sjoppich/ELEC5552-Team-14/Code/Arduino Mega Pinouts.pdf

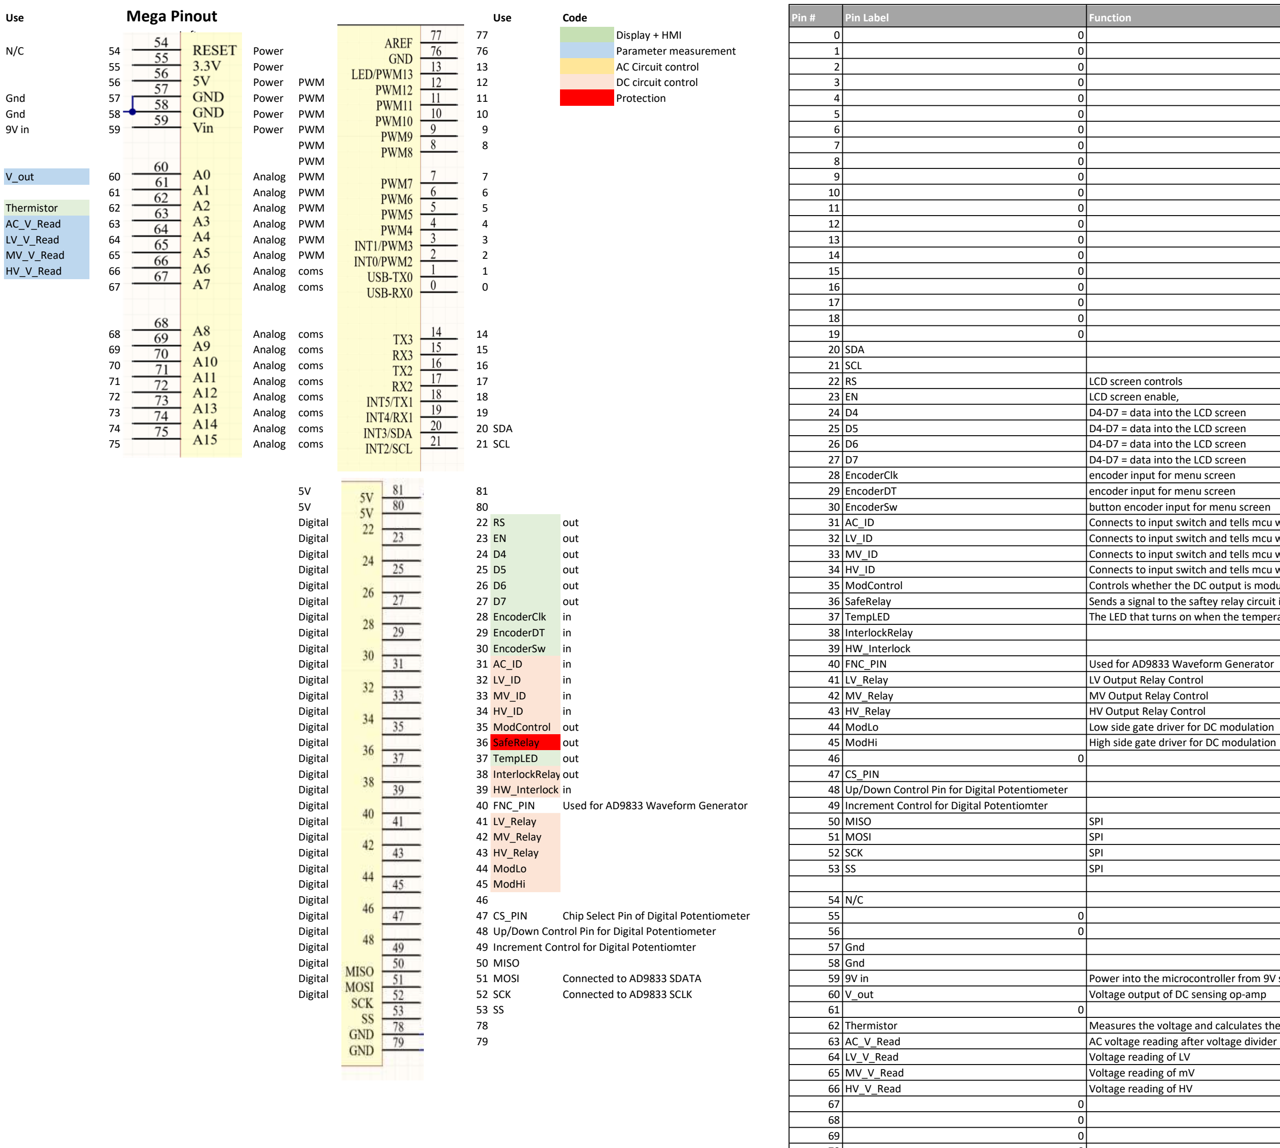
[picture p1: figure]
Use; Mega Pinout; Code; Pin #; Pin Label; Function; Left; Display + HMI; Power; Parameter measurement; AC Circuit control; Power PWM; DC circuit control; Gnd; Protection; PWM; V_out; Analog PWM; Thermistor; AC_V_Read; LV_V_Read; MV_V_Read; HV_V_Read; Analog coms; SDA; SCL; LCD screen controls; LCD screen enable,; D4-D7 = data into the LCD screen; EncoderClk; encoder input for menu screen; EncoderDT; Digital; 29 EncoderDT; InterlockRelay; 30 EncoderSw in; HW_Interlock; FNC_PIN; Used for AD9833 Waveform Generator; LV_Relay; LV Output Relay Control; MV_Relay; MV Output Relay Control; HV_Relay; HV Output Relay Control; 37 TempLED; out; InterlockRelay out; CS_PIN; 40 FNC_PIN; Increment Control for Digital Potentiomter; MISO; SPI; MOSI; SCK; ModLo; 45 ModHi; 50 MISO; Voltage reading of LV; Voltage reading of mV; Voltage reading of HV
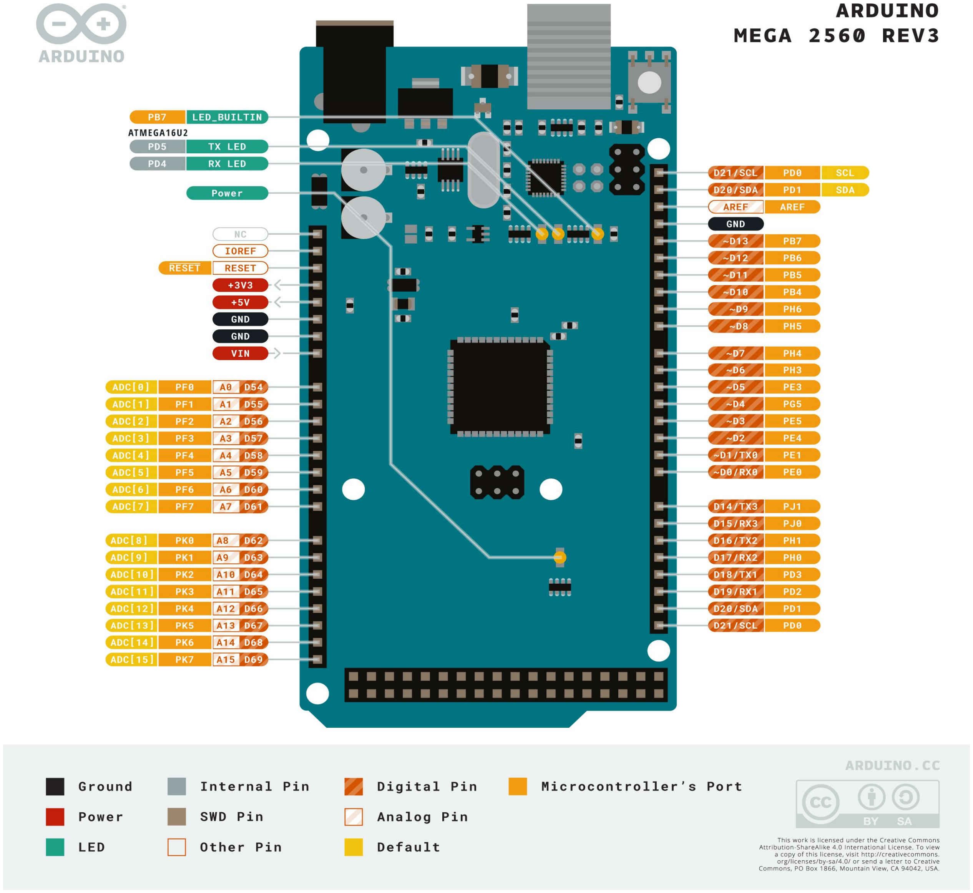
[picture p2: figure]

73 | Analog coms | 19 | 24 | D4 | D4-D7 = data into the LCD screen
74 | Analog coms | 20 SDA | 25 | D5 | D4-D7 = data into the LCD screen
75 | Analog coms | 21 SCL | 26 | D6 | D4-D7 = data into the LCD screen
5V | 80 | | 30 | EncoderSw | button encoder input for menu screen
Digital | 22 RS | out | 31 | AC_ID | Connects to input switch and tells mcu whether its switched to HV,MV,LV or AC
Digital | 23 EN | out | 32 | LV_ID | Connects to input switch and tells mcu whether its switched to HV,MV,LV or AC
Digital | 24 D4 | out | 33 | MV_ID | Connects to input switch and tells mcu whether its switched to HV,MV,LV or AC
Digital | 25 D5 | out | 34 | HV_ID | Connects to input switch and tells mcu whether its switched to HV,MV,LV or AC
Digital | 26 D6 | out | 35 | ModControl | Controls whether the DC output is modulated or not
Digital | 27 D7 | out | 36 | SafeRelay | Sends a signal to the saftey relay circuit in case of overcurrent, thermal overheat or other failure
Digital | 28 EncoderClk in | 37 | TempLED | The LED that turns on when the temperature warning is exceeded
Digital | 35 ModControl out | 44 | ModLo | Low side gate driver for DC modulation
Digital | 36 SafeRelay | out | 45 | ModHi | High side gate driver for DC modulation
Digital | 39 | HW_Interlock in | 48 | Up/Down Control Pin for Digital Potentiometer
Digital | 47 CS_PIN | Chip Select Pin of Digital Potentiometer | 55 | 0
Digital | 48 Up/Down Control Pin for Digital Potentiometer | 56 | 0
Digital | 49 Increment Control for Digital Potentiomter | 57 | Gnd
Digital | 51 MOSI | Connected to AD9833 SDATA | 59 | 9V in | Power into the microcontroller from 9V supply
Digital | 52 SCK | Connected to AD9833 SCLK | 60 | V_out | Voltage output of DC sensing op-amp
| 78 | | 62 | Thermistor | Measures the voltage and calculates the resulting temperature
| 79 | | 63 | AC_V_Read | AC voltage reading after voltage divider

70 0
71 0
72 0
73 0
74 0
75 0
76 0
77 0
78 0
79 0
80 0
81 0
