sjoppich/ELEC5552-Team-14/Altium Schematics+PCB/ELEC5552_Team_14_Schematic.pdf

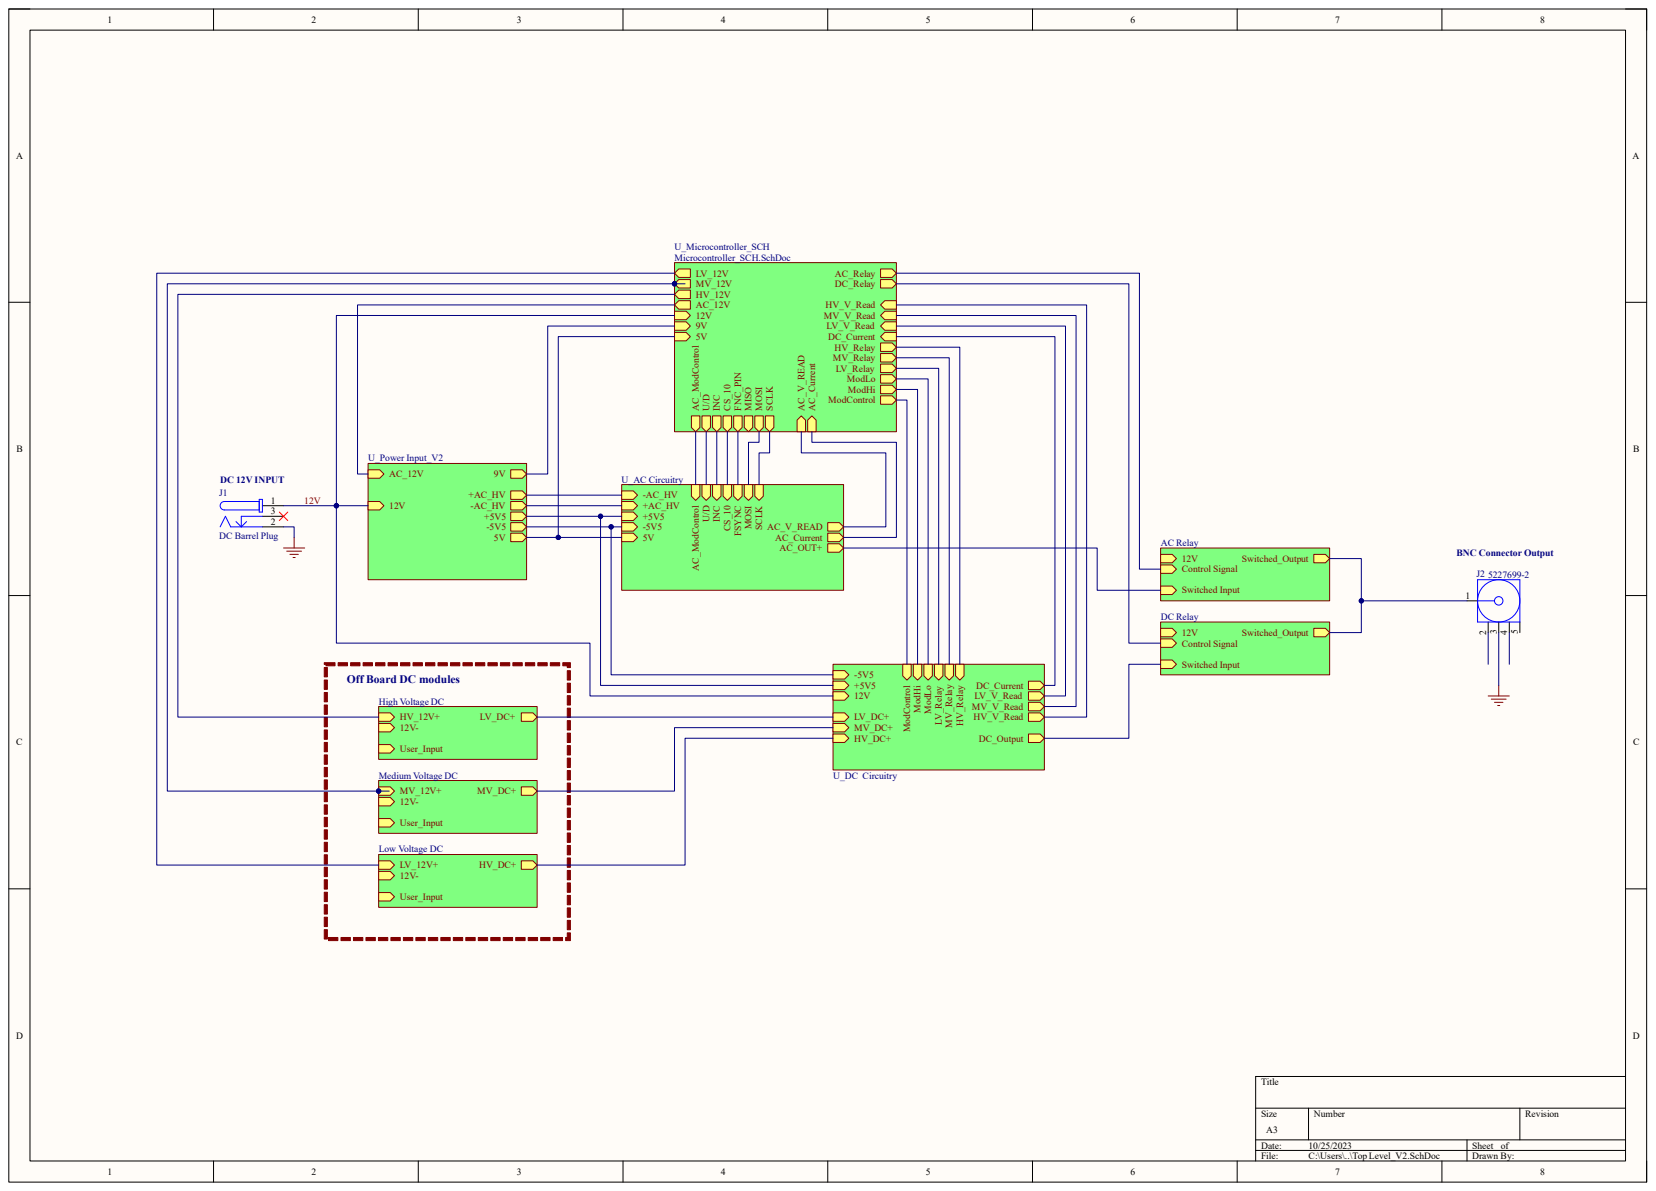
[picture p19: page 1]
Title; Size; Number; Revision; Date:; Sheet of; File:; C:\Users\..\Top Level_V2.SchDoc; Drawn By:; AC_V_READ; LV_V_Read; MV_V_Read; HV_V_Read; ModControl; AC_Relay; DC_Current AC_Current; DC_Relay FNC_PIN; LV_Relay; MV_Relay; HV_Relay; ModLo; ModHi AC_ModControl U/D INC CS_10; MISO MOSI SCLK; U_Microcontroller_SCH Microcontroller_SCH.SchDoc; User_Input; Low Voltage DC; High Voltage DC; Medium Voltage DC; DC 12V INPUT; U_Power Input_V2; DC_Current; DC_Output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

DC Barrel Plug

BNC Connector Output

Off Board DC modules

# ELV Supply Voltages

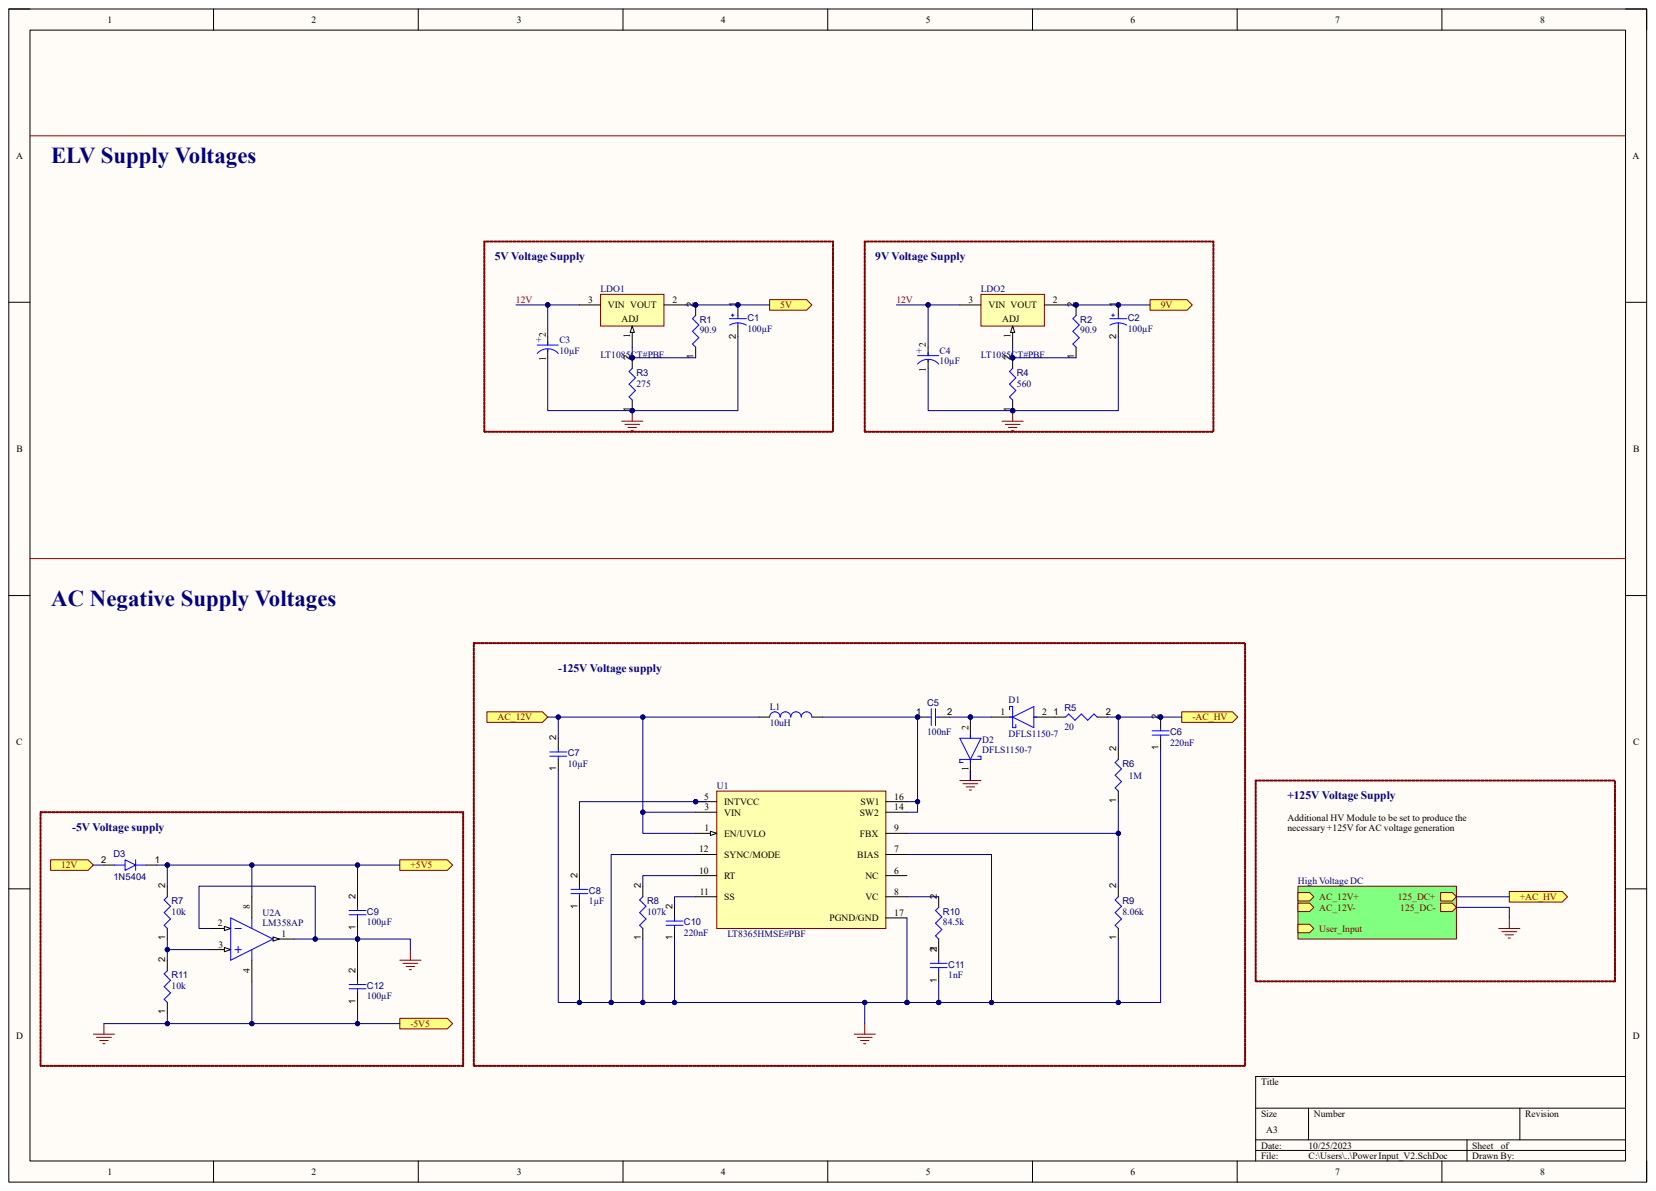
[picture p20: page 2]

AC Negative Supply Voltages

Additional HV Module to be set to produce the
necessary +125V for AC voltage generation

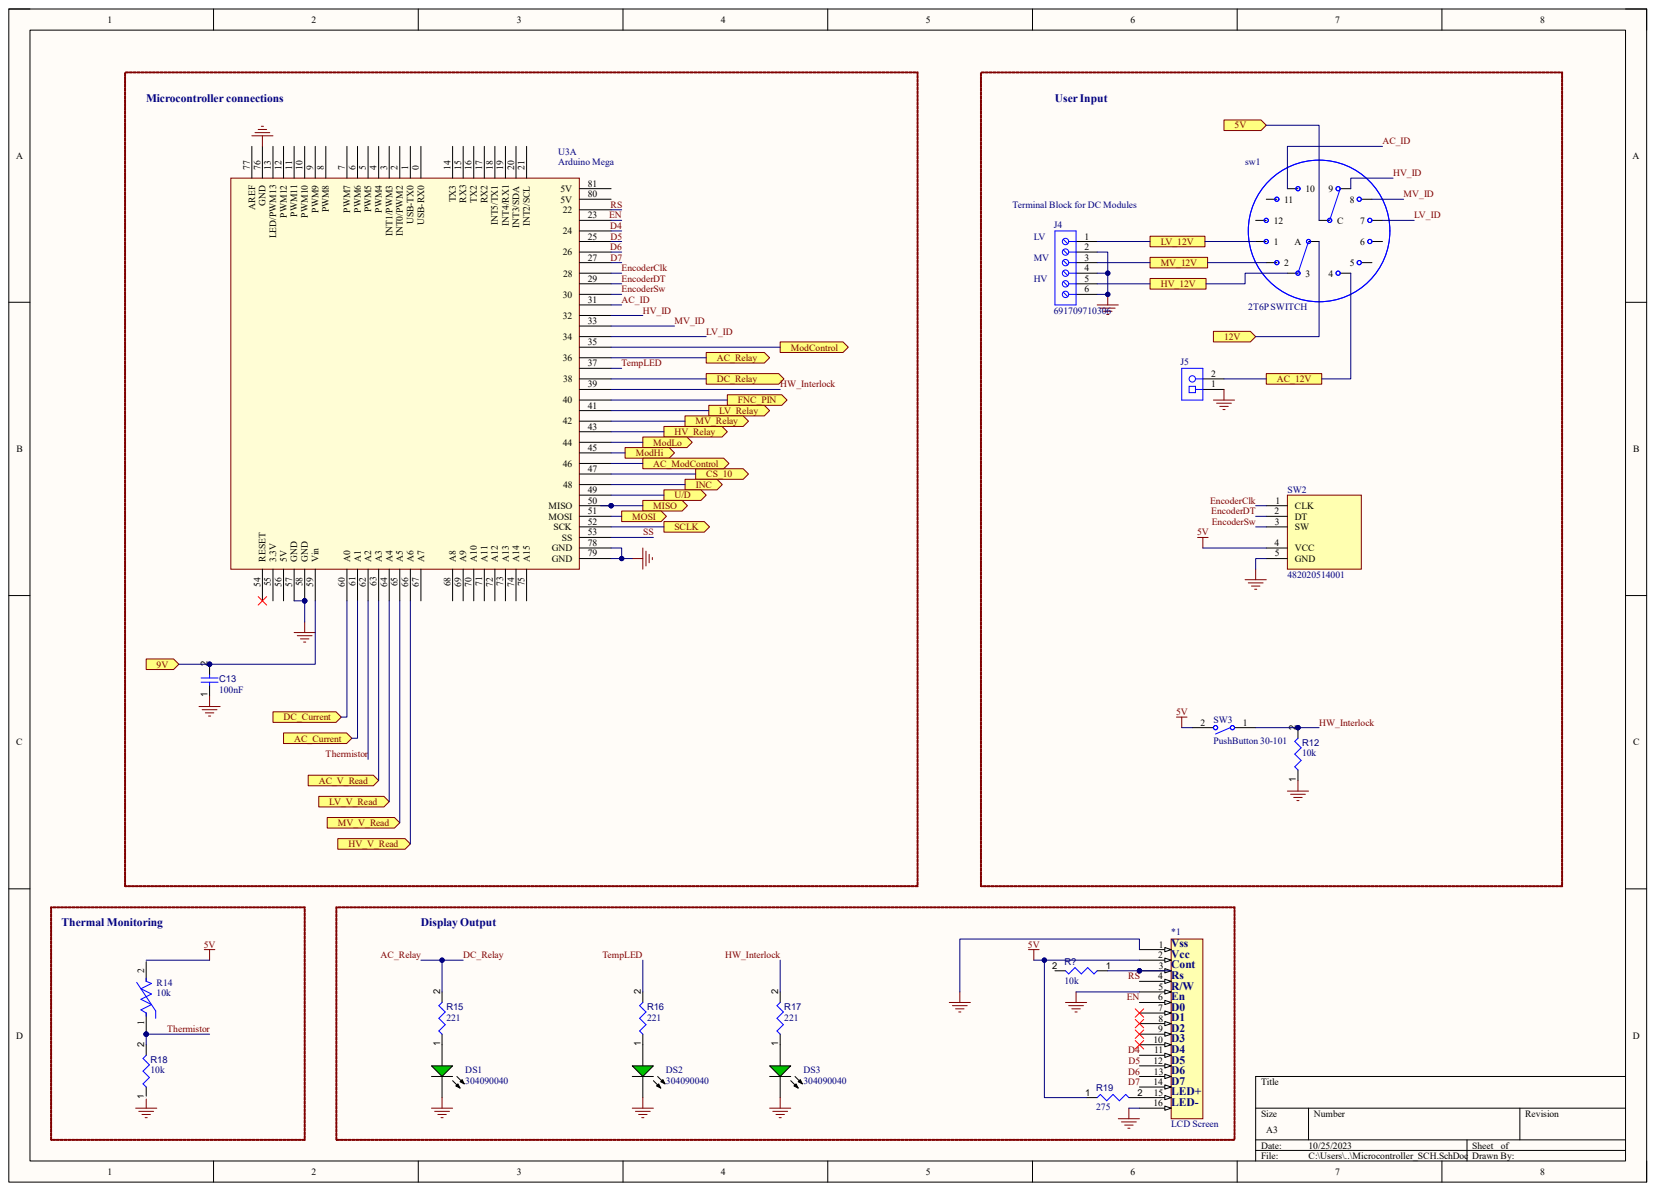
[picture p21: page 3]

Terminal Block for DC Modules

# TL071CP ⁺⁵V⁵ -5V⁵

C17 1 2

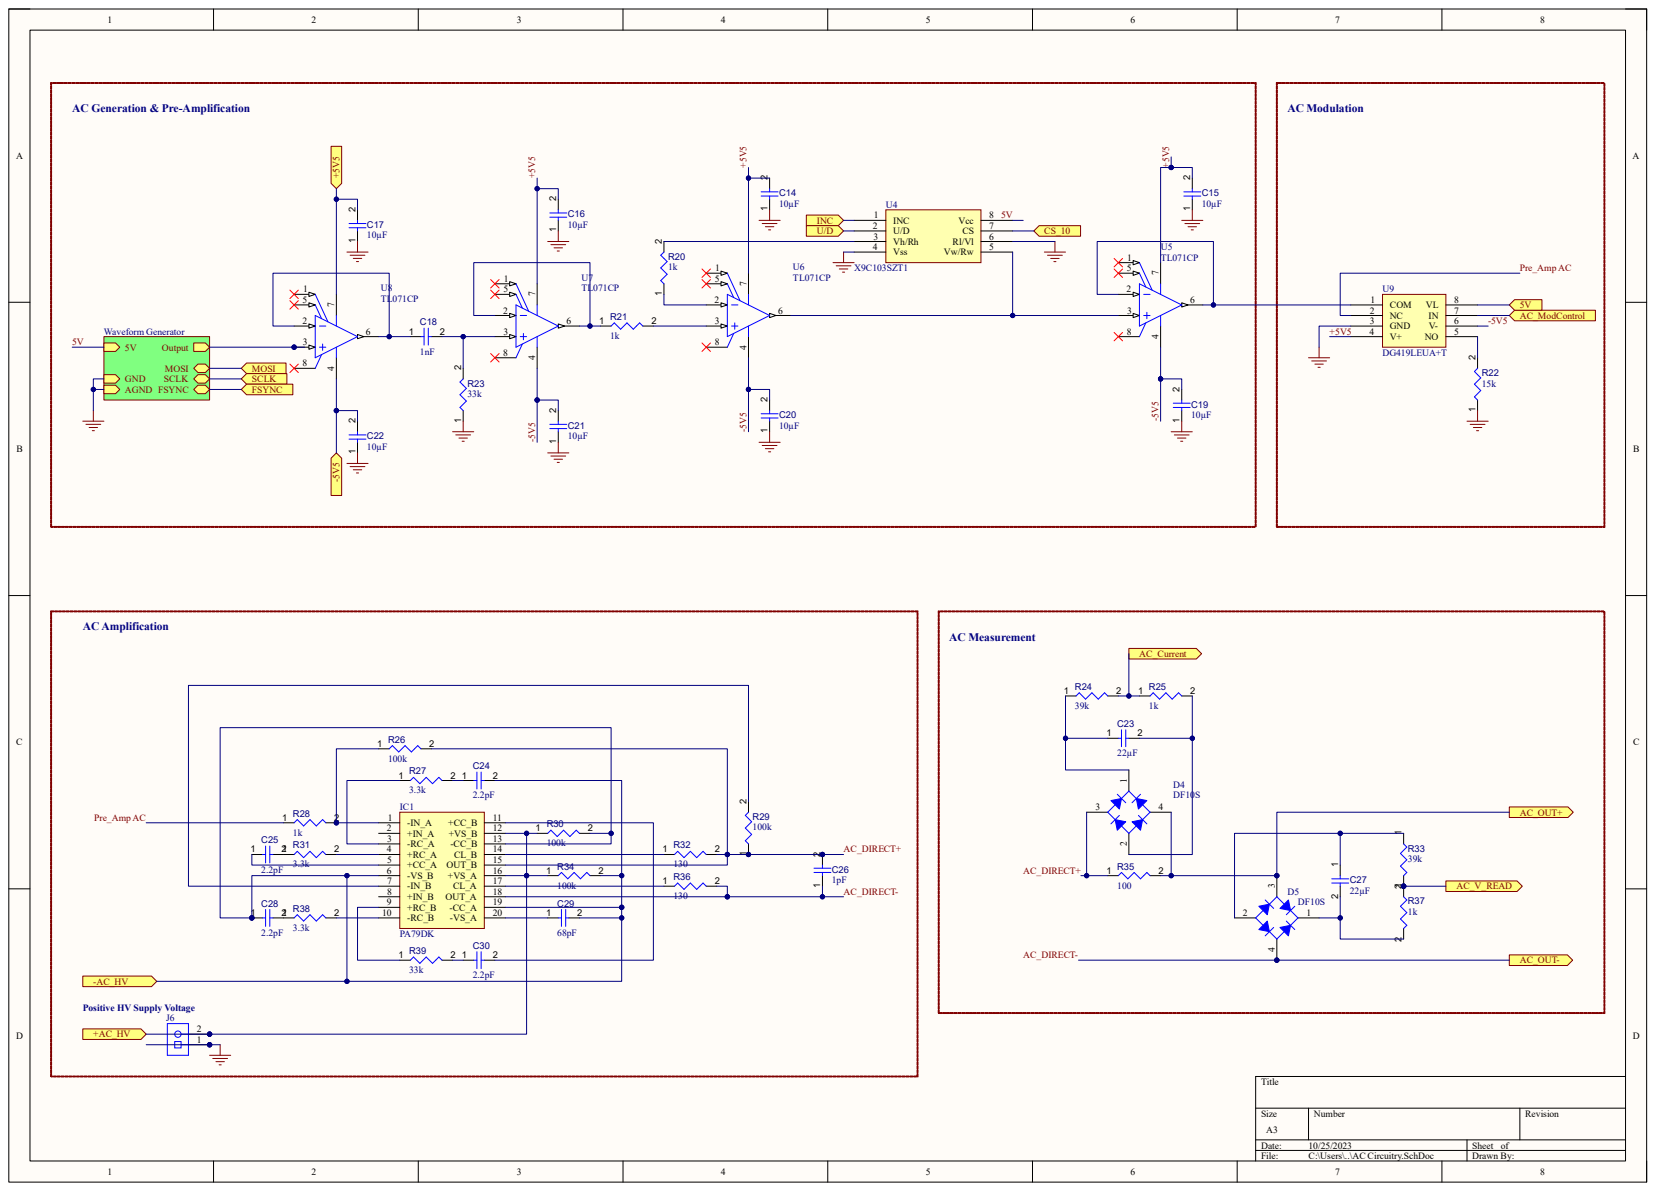
[picture p22: page 4]

AC Generation & Pre-Amplification

Positive HV Supply Voltage

A A

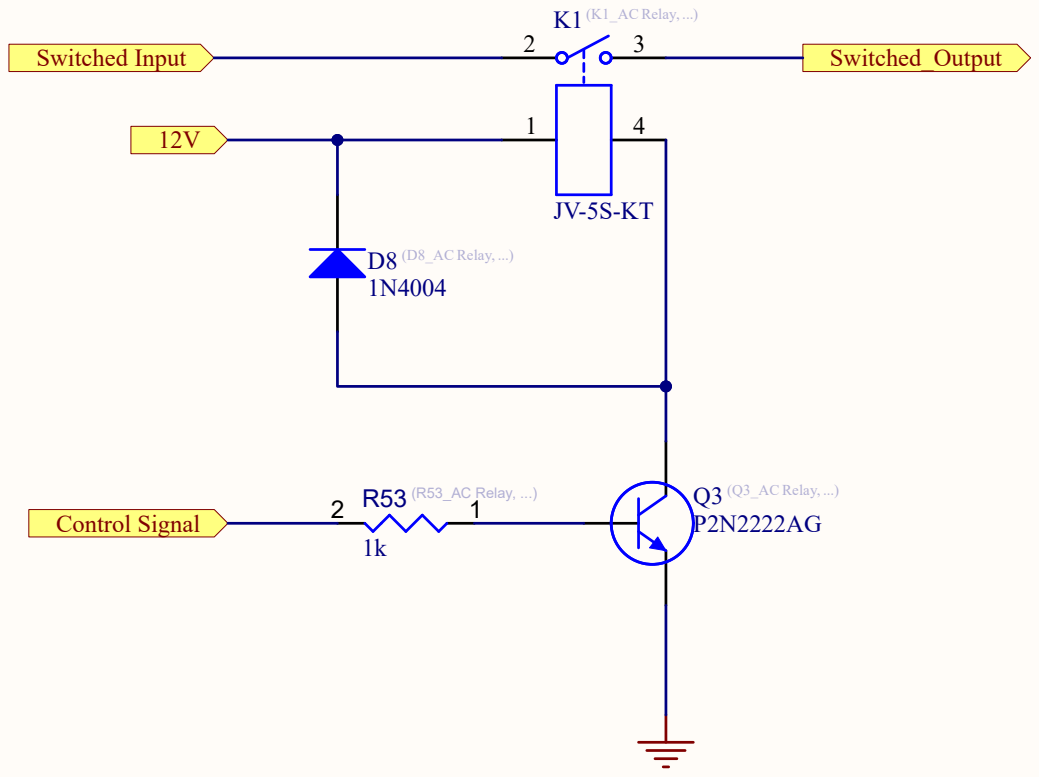
[picture p23: page 5]
Title; Size; Number; Revision; File:; C:\Users\..\Relay Control.SchDoc; Drawn By:; Q3 ⁽Q3_AC Relay, ...) P2N2222AG; D8 ⁽D8_AC Relay, ...) 1N4004; K1⁽K1_AC Relay, ...); R53 ⁽R53_AC Relay, ...); Switched Input; Switched_Output; Control Signal

R41 2 1

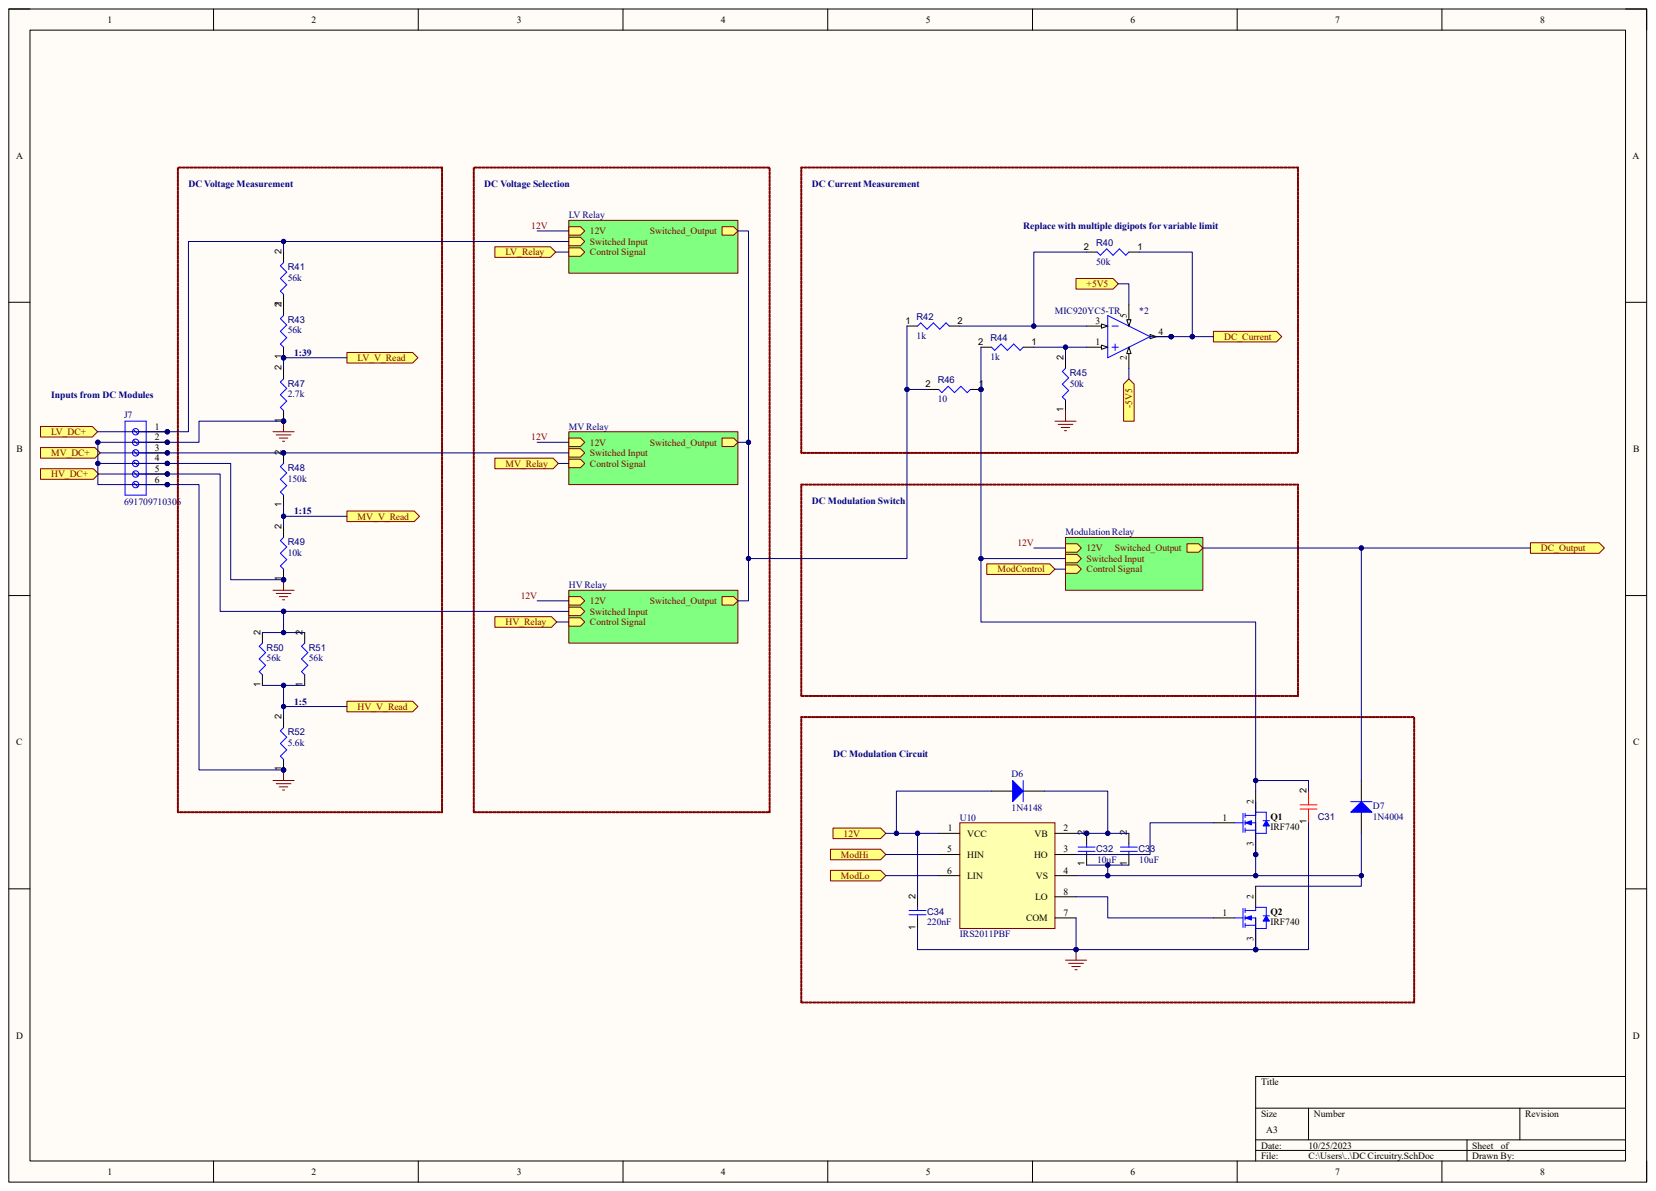
[picture p24: page 6]

Replace with multiple digipots for variable limit
