sjoppich/ELEC5552-Team-14/Block Diagram/ELEC5552 System block Diagram_V2.pdf

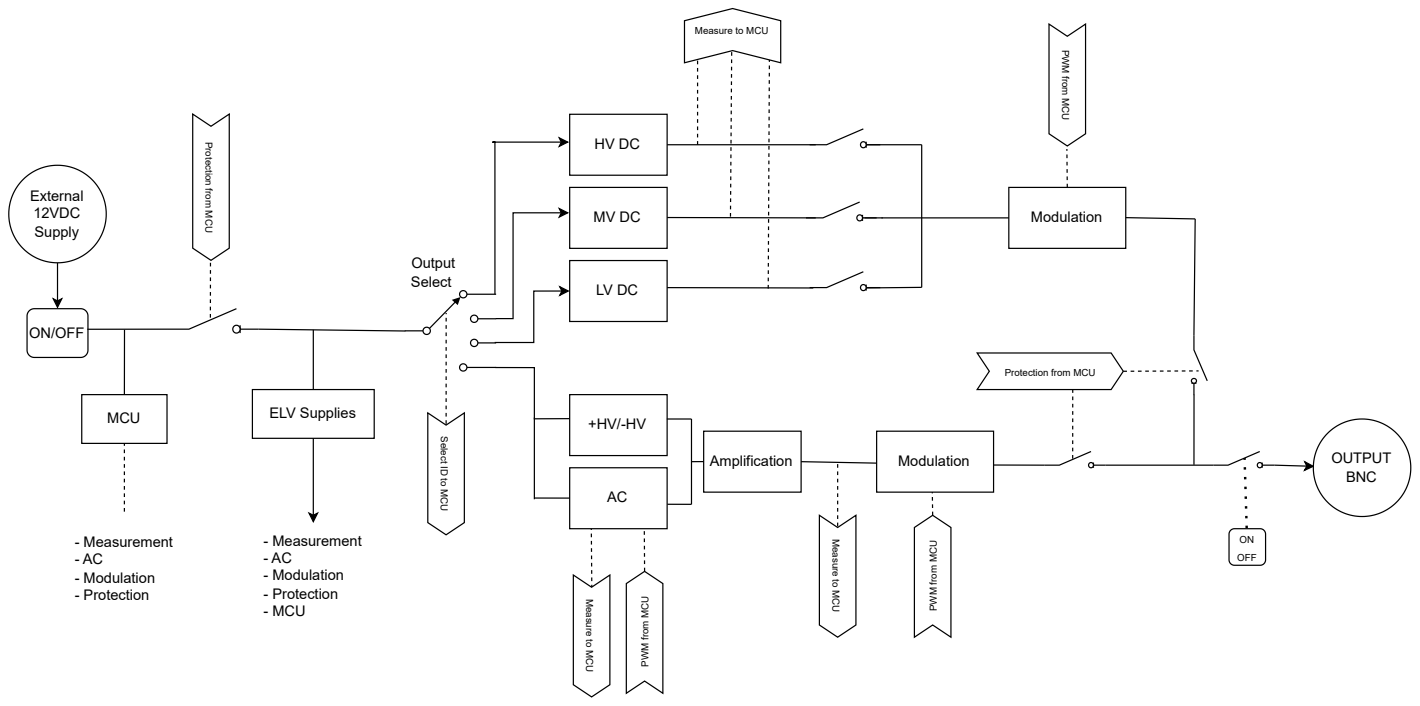
[picture p25: page 1]
Modulation; Amplification; ON/OFF; MCU; ELV Supplies; External 12VDC Supply; OUTPUT BNC; - Measurement - AC - Modulation - Protection - MCU; - Measurement - AC - Modulation - Protection; OFF

Measure to MCU

PWM from MCU

Protection from MCU

Output
Select Select ID to MCU
