sjoppich/ELEC5552-Team-14/Simulation Files/05. DC measurement + protection/DC current measurement + protection_simplified.asc

C1: cap; 100p
R1: res; 47k
R2: res; 1k
R3: res; 47k
R4: res; 1k
Rs: res; 10
V1: voltage; 200
Named nets: 0, V1, V2, V2_scaled, V1_scaled
.tran 10
To microcontroller
Current-sensing resistor
MEMS load
To microcontroller
