sjoppich/ELEC5552-Team-14/Simulation Files/01. Component Low Voltage Generation/LT1085_3_3_V_Power_Supply_Schematic.asc

C1: cap; 100µ
C2: cap; 10µ
R1: res; 275
R2: res; 90.9
U1: LT1085
V1: voltage; PULSE(0 12 500n 0 0 20m 20m)
Named nets: 0, V_OUT
.tran 0 1 0 1m
