sjoppich/ELEC5552-Team-14/Simulation Files/02. Waveform Generation/Practical_Single_Stage_Inverting_Amplifier_Schematic_with_Buffer_With_Actual_Parts.asc

R1: res; 10k
R2: res; 28.2
U1: LT1818
U2: LT1818
V1: signal; SINE(0 0.65 50K)
V2: voltage; -10
V3: voltage; 30
V6: voltage; -10
V7: voltage; 10
Named nets: 0, V_Out
.tran 0 50u 0 1u
