sjoppich/ELEC5552-Team-14/Simulation Files/03. AC measurement/Full bridge rectifier.asc

C5: cap; 10n; V=4 Irms=2.7 Rser=0.035 Lser=0
C6: cap; 0.47n
C7: cap; 220µ; V=4 Irms=2.7 Rser=0.035 Lser=0
C8: cap; 0.47n
C9: cap; 10p
C10: cap; 10n; V=4 Irms=2.7 Rser=0.035 Lser=0
D9: schottky; 1N5819
D10: schottky; 1N5819
D11: schottky; 1N5819
D12: schottky; 1N5819
D13: schottky; 1N5819
D14: schottky; 1N5819
D15: schottky; 1N5819
D16: schottky; 1N5819
D17: schottky; 1N5819
D18: schottky; 1N5819
D19: schottky; 1N5819
D20: schottky; 1N5819
R1: res; 0
R2: res; 0
R8: res; 30k
R9: res; 500
R10: res; 10k
R11: res; 1m
R12: res; 60k
R13: res; 1k
R14: res; 10k
R15: res; 30k
R16: res; 400
V2: voltage; SINE(-0.1 70 300k)
V3: voltage; SINE(-0.1 288 10k)
Named nets: 0
;dc AC 20 5s 0 0.2
;dc AC 20 5s 0 0.2
Load
Scaled Voltage
.tran 0 50us 0
Leftovers- ignore
Will need to check power ability of the resistors- cant handle high voltage
