sjoppich/ELEC5552-Team-14/Simulation Files/04. DC to AC Full Stage/Practical_Single_Stage_Inverting_Amplifier_Schematic_with_Buffer_With_Actual_Parts.asc

L1: ind
R1: res; 10k
R2: res; 50k
R3: res; 1k
R4: res; 10k
U1: LT1818
U2: LT1818
U3: LT1818
U4: ADHV4702-1
V1: voltage; 110
V2: voltage; -5
V3: signal; SINE(0 0.65 300K)
V4: voltage; -110
V5: signal; SINE(0 35 50K)
V10: voltage; 5
Named nets: 0, V+5, V-5, V_Wave, V+High, V-Low, V_Out, V_Pre, V_Wave_Comparsion
.tran 0 50u 0 1u
