sjoppich/ELEC5552-Team-14/Simulation Files/05. DC measurement + protection/DC current measurement + protection.asc

I1: current; 10m
R1: res; 1k
R2: res; 50k
R3: res; 1k
R4: res; 50k
R5: res; 100
R6: res; 100
R7: res; 100k
Rs: res; 10
U1: OP27
V1: voltage; 9
V2: voltage; -9V
Named nets: 0, V1, V2, V_out, V+, V-
.tran 10
Current-sensing resistor
To microcontroller
To load
