sjoppich/ELEC5552-Team-14/Simulation Files/01. Component Low Voltage Generation/Component Voltage Generation/Component_Voltage_Generation_LT_Spice_Schematic.asc

C1: cap; 100µ
C2: cap; 10µ
C3: cap; 100µ
C4: cap; 10µ
C5: cap; 100µ
C6: cap; 10µ
R1: res; 560
R2: res; 90.9
R3: res; 150
R4: res; 90.9
R5: res; 277
R6: res; 90.9
U1: LT1085
U2: LT1085
U3: LT1085
V1: voltage; PULSE(0 12 500n 0 0 20m 20m)
V2: voltage; PULSE(0 12 500n 0 0 20m 20m)
V3: voltage; PULSE(0 12 500n 0 0 20m 20m)
Named nets: 0, V_OUT3, V_OUT, V_OUT2
.tran 1
