sjoppich/ELEC5552-Team-14/Simulation Files/06. Dual Supply/5V.asc

C1: cap; 100µ
C2: cap; 100µ
D1: diode
R1: res; 10k
R2: res; 10k
U1: AD711
V1: voltage; 12
Named nets: 0
.tran 30
