sjoppich/ELEC5552-Team-14/Simulation Files/06. Dual Supply/lt8365_boost.asc

C1: cap; 0.22µ
C2: cap; 1µ
C3: cap; 1000p
C4: cap; .22µ; Rser=9m
C5: cap; 10µ
C6: cap; 0.1µ
D1: schottky; RB068L150
D2: schottky; RB068L150
L1: ind; 10µ; Rser=6m
R1: res; 107K
R2: res; 1Meg
R3: res; 5.5k
R4: res; 84.5K
R5: res; 20
U1: LT8365
V1: VOLTAGE; 12
Named nets: 0, IN, OUT
.tran 10 steady
Note:
  A smaller SS capacitor is being used to reduce simulation time. See datasheet for typical values.
  If the simulation model is not found please update with the "Sync Release" command from the "Tools" menu.
  It remains the customer's responsibility to verify proper and reliable operation in the actual application.
  Component substitution and printed circuit board layout may significantly affect circuit performance or reliability.
  Contact your local sales representative for assistance. This circuit is distributed to customers only for use with LTC parts.
  Copyright © 2020 Analog Devices Inc. All rights reserved.
LT8365 - Low Iq Boost/SEPIC/Inverting DC/DC Converter with 1.5A, 150V Switch
125V Boost Converter
Input: 9V to 30V     Output: 125V @ 20mA, Fsw = 400KHz
