sjoppich/ELEC5552-Team-14/(list of files, drawings)

Other design files:
Altium Schematics+PCB/AC Circuitry.SchDoc
Altium Schematics+PCB/DC Circuitry.SchDoc
Altium Schematics+PCB/Microcontroller_SCH.SchDoc
Altium Schematics+PCB/Power Input_V2.SchDoc
Altium Schematics+PCB/Relay Control.SchDoc
Altium Schematics+PCB/Top Level_V2.SchDoc
