sjoppich/ELEC5552-Team-14/(commit log)

2023-10-25 Upload Bill of Materials Folder
2023-10-25 Upload Altium Schematics+PCB Folder
    [AC Circuitry.SchDoc, DC Circuitry.SchDoc, Microcontroller_SCH.SchDoc, Power Input_V2.SchDoc, Relay Control.SchDoc, Top Level_V2.SchDoc]
2023-10-25 Updated BoM
2023-10-25 Uploaded Arduino Mega Pinouts
2023-10-26 Updated DC current measurement + protection files
